nhim411/IoT-module-for-BCS2/DOC/HARDWARE/SCHEMATIC/BUTTONLED_SCHE.pdf

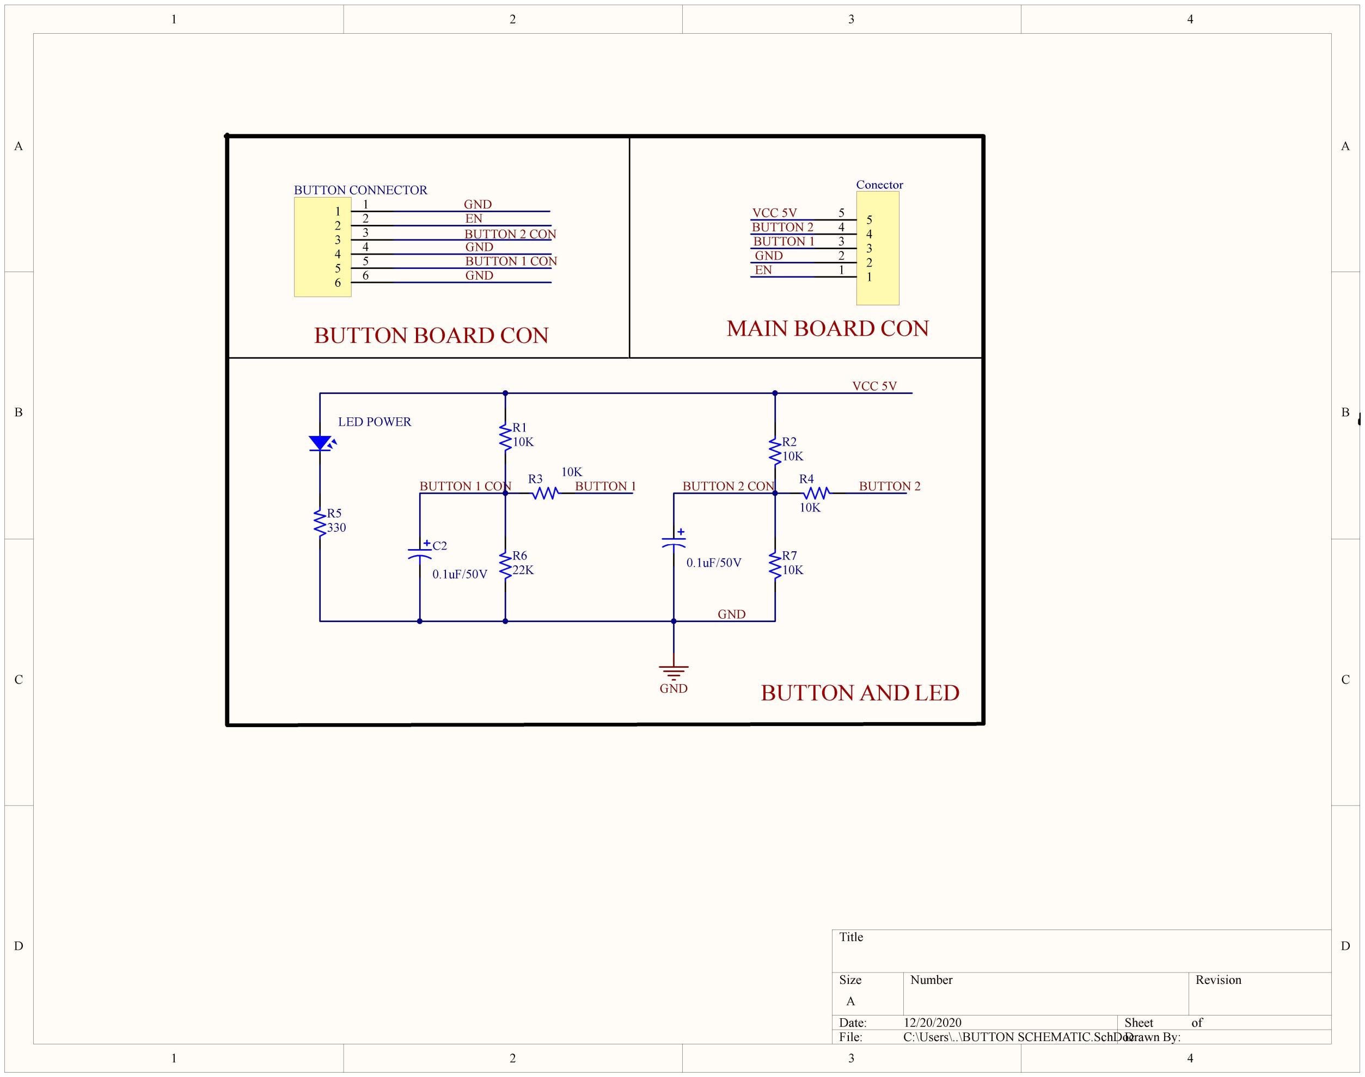
[picture p5: page 1]

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
Title

Size | Number | | Revision
A
Date: | 12/20/2020 | Sheet | of
File: | C:\Users\..\BUTTON SCHEMATIC.SchDocDrawn By:

R1
10K

R3 10K

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
Conector

GND

LED POWER

R5
330

0.1uF/50V

C2
0.1uF/50V

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
BUTTON CONNECTOR

GND

GND

EN

EN

BUTTON 1

BUTTON 1 CON | BUTTON 1

BUTTON 1 CON

BUTTON 2 CON

BUTTON 2 CON

GND

GND

VCC 5V

GND

VCC 5V
BUTTON 2

BUTTON 2

BUTTON BOARD CON | MAIN BOARD CON

# BUTTON AND LED
