nhim411/IoT-module-for-BCS2/DOC/HARDWARE/SCHEMATIC/LAN8720_SCHE.pdf

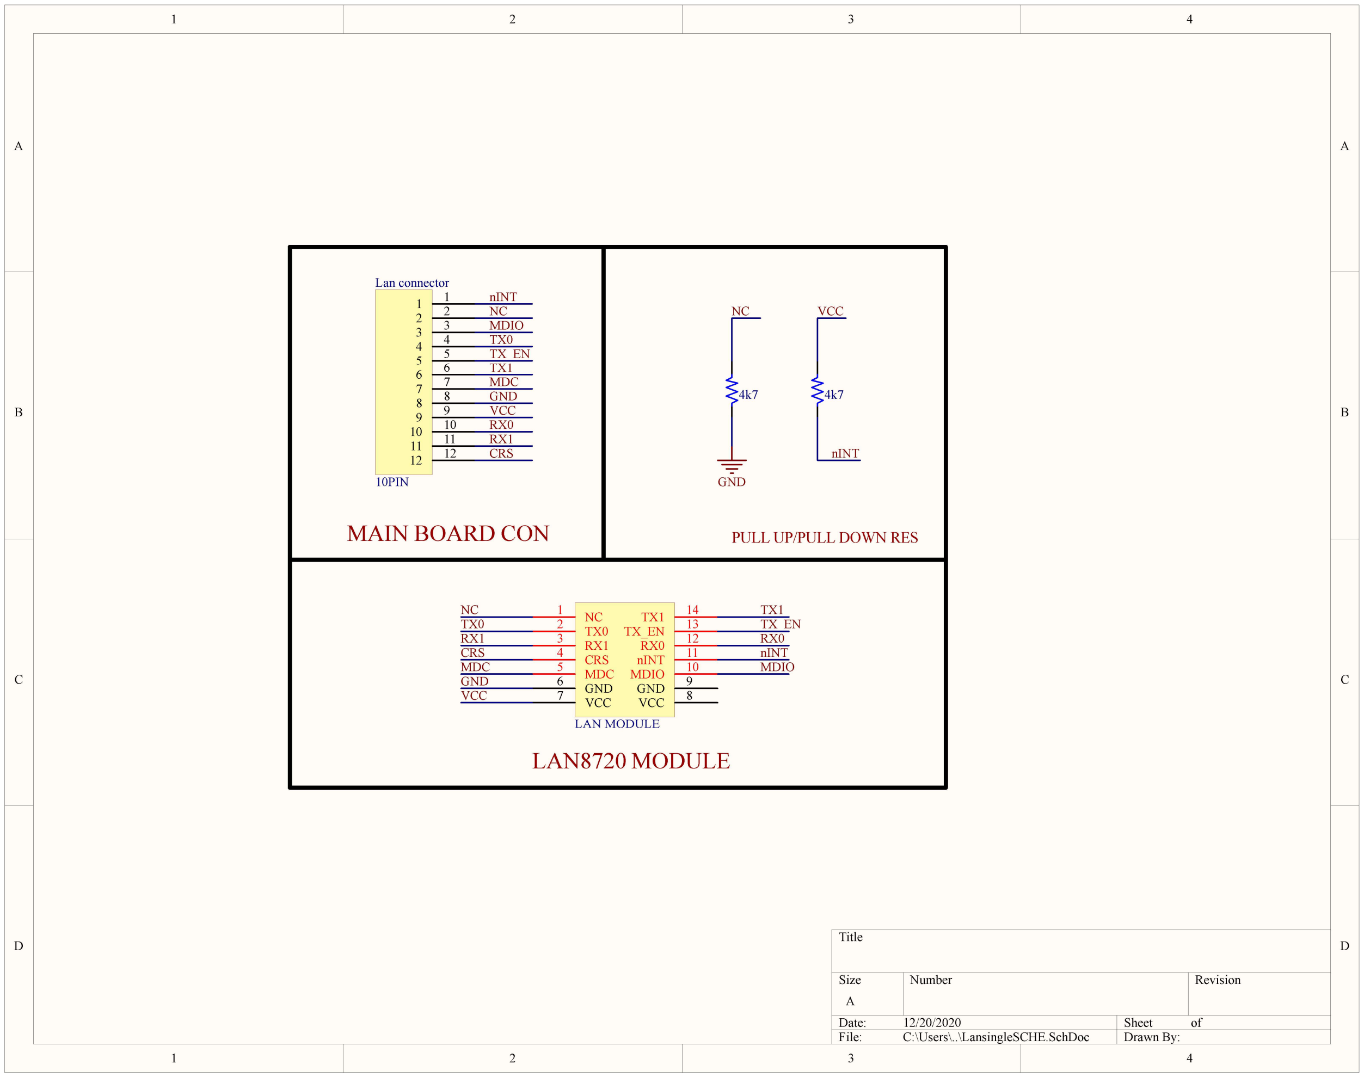
[picture p6: page 1]

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
Title

Size | Number | | Revision
A
Date: | 12/20/2020 | Sheet | of
File: | C:\Users\..\LansingleSCHE.SchDoc | Drawn By:
VCC | 8
GND | 9 MDIO | 10 nINT | 11 RX0 | 12 TX_EN | 13 TX1 | 14 NC 1
TX0 2
RX1 3
CRS 4
MDC 5
GND 6
VCC 7

LAN MODULE

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
10 10
11 11
12 12

Lan connector

10PIN

CRS

RX1

RX0

VCC

GND

MDC

TX1

TX_EN

TX0

MDIO

NC

nINT

4k7 | 4k7

CRS

RX1 | RX0 TX1
| nINT

NC

MDIO
GND
VCC

MDC

TX0 | TX_EN

GND

nINT

NC | VCC
MAIN BOARD CON | PULL UP/PULL DOWN RES

# LAN8720 MODULE
