nhim411/IoT-module-for-BCS2/DOC/HARDWARE/SCHEMATIC/MAIN_CHEMATIC.pdf

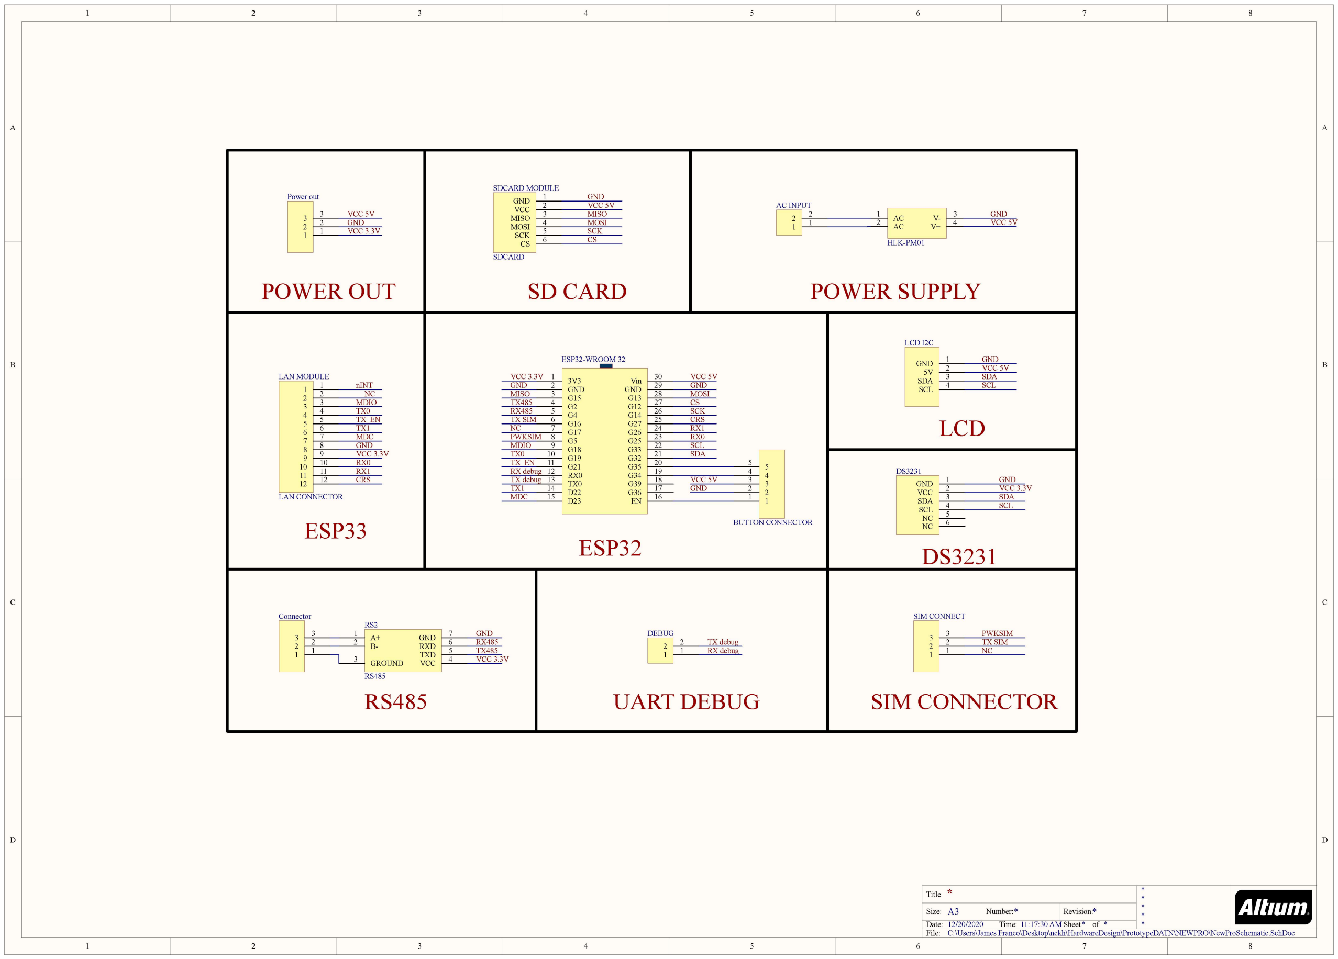
[picture p7: page 1]

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
* | *

*

* | *
12/20/2020 | 11:17:30 AM
C:\Users\James Franco\Desktop\nckh\HardwareDesign\PrototypeDATN\NEWPRO\NewProSchematic.SchDoc

Title

Size: | Number:
Date:
File:

Revision:
Time: | Sheet | of

A3

3V3 1
GND 2
G15 3
G2 4
G4 5
G16 6
G17 7
G5 8
G18 9
G19 10
G21 11
RX0 12
TX0 13
D22 14
D23 15 | EN | 16 G36 | 17 G39 | 18 G34 | 19 G35 | 20 G32 | 21 G33 | 22 G25 | 23 G26 | 24 G27 | 25 G14 | 26 G12 | 27 G13 | 28 GND | 29 Vin | 30

ESP32-WROOM 32

AC 1
AC 2
V- | 3
V+ | 4

HLK-PM01

1

1

2

2

AC INPUT
GND
VCC 5V

VCC 5V
GND | GND 1

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
10 10
11 11
12 12

LAN MODULE

LAN CONNECTOR

nINT
NC
MDIO
TX0
TX_EN
TX1
MDC
GND
VCC 3.3V

RX1

RX0

CRS

VCC 3.3V

NC

MDIO
TX0
TX_EN

TX1
MDC

RX0

RX1

CRS

GND | 1
5V | 2
SDA | 3
SCL | 4

LCD I2C

SCL

SDA

VCC 5V

GND

SCL
SDA

A+ 1
B- 2
GROUND 3 | VCC | 4
| TXD | 5
RXD | 6
GND | 7

RS2

RS485

GND

VCC 3.3V

RX485
TX485 1

1

2

2

3

3

Connector

1

1

2

2

3

3

Power out

VCC 5V

VCC 3.3V

GND

1

1

2

2

DEBUG

RX debug

RX debug
TX debug

TX debug
1

1

2

2

3

3

SIM CONNECT

PWKSIM
TX SIM

TX SIM

NC

PWKSIM

GND | 1
VCC | 2
MISO | 3
MOSI | 4
SCK | 5
CS | 6

SDCARD MODULE

SDCARD

VCC 5V

GND

MISO

MISO

MOSI

MOSI

SCK

SCK
CS

CS

GND | 1
VCC | 2
SDA | 3
SCL | 4
NC | 5
NC | 6

DS3231
GND

SDA
SCL

VCC 3.3V

TX485
RX485

VCC 5V
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
BUTTON CONNECTOR

# ESP32

SD CARD | POWER SUPPLY

DS3231

# LCD

RS485 | UART DEBUG | SIM CONNECTOR

# ESP33

# POWER OUT
