nhim411/IoT-module-for-BCS2/DOC/HARDWARE/MACH_IN/BUTTON/BUTLAYOUT.JPG

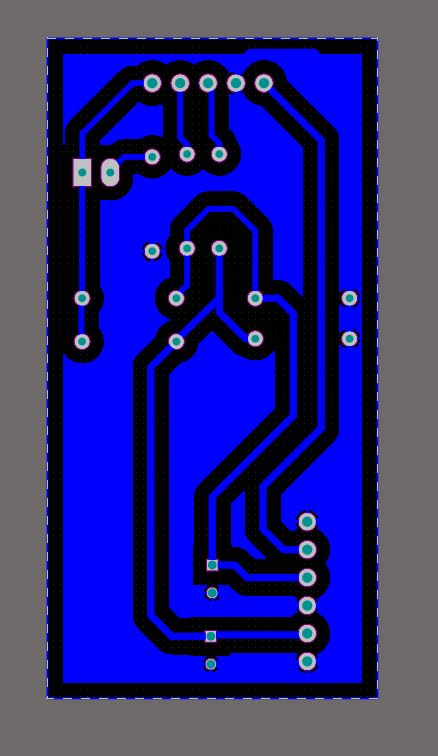
DOC/HARDWARE/MACH_IN/BUTTON/BUTLAYOUT.JPG
