nhim411/IoT-module-for-BCS2/DOC/HARDWARE/MACH_IN/LAN/lANLAYOUT2.JPG

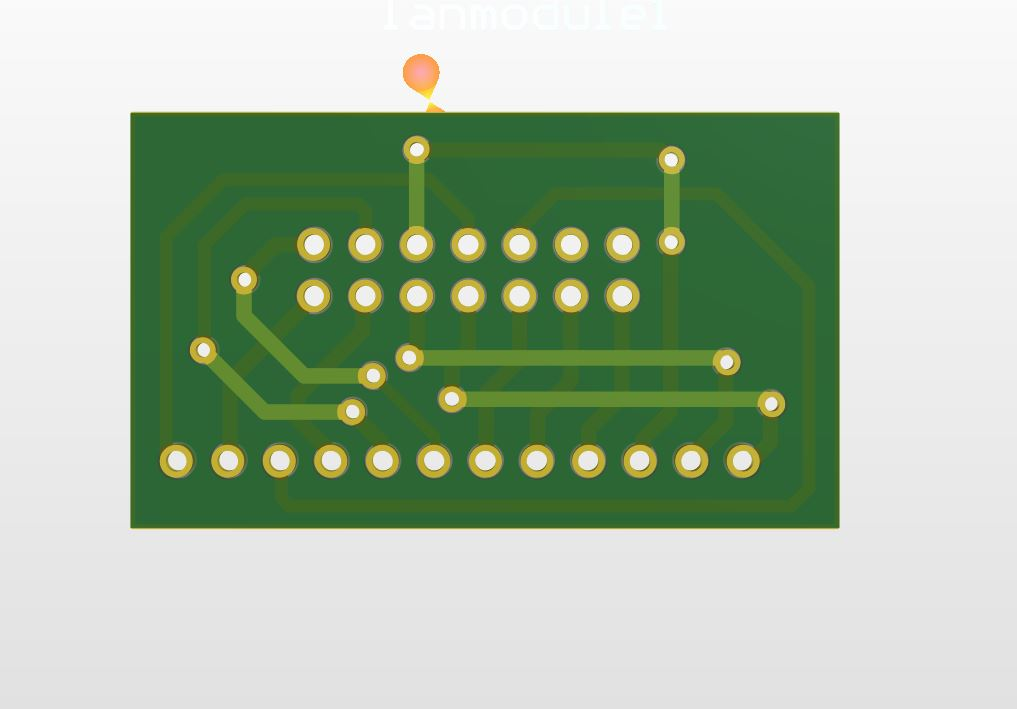
DOC/HARDWARE/MACH_IN/LAN/lANLAYOUT2.JPG
