nhim411/IoT-module-for-BCS2/DOC/HARDWARE/MACH_IN/LAN/lANLAYOUT.JPG

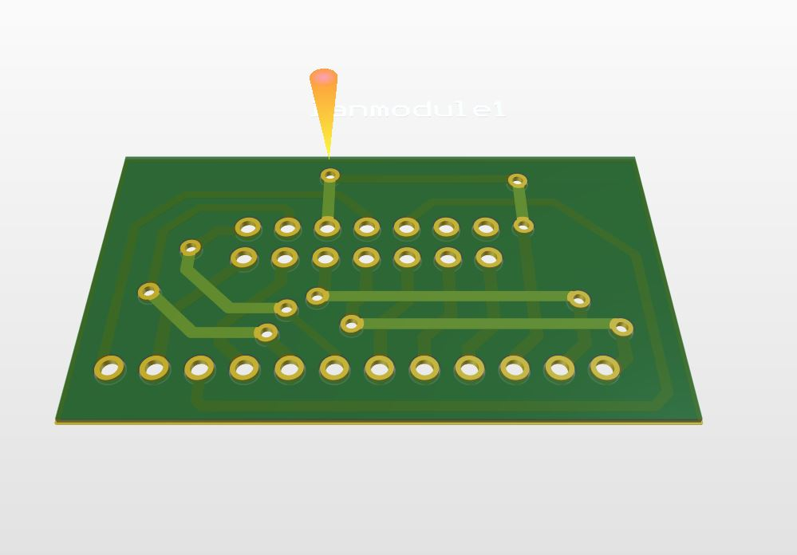
DOC/HARDWARE/MACH_IN/LAN/lANLAYOUT.JPG
