nhim411/IoT-module-for-BCS2/DOC/HARDWARE/MACH_IN/MAIN/Capture.JPG

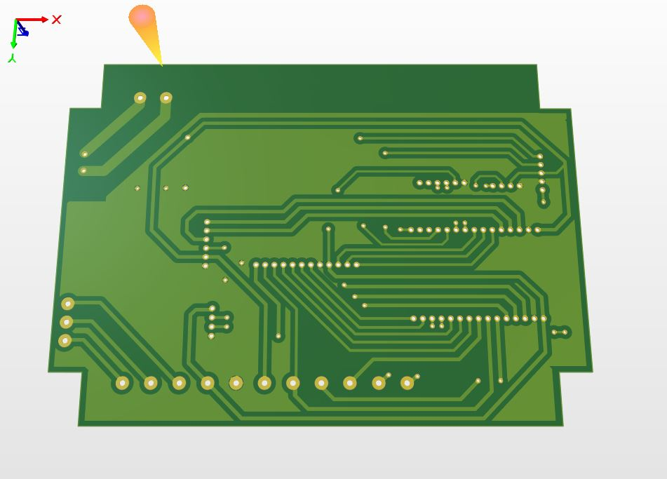
DOC/HARDWARE/MACH_IN/MAIN/Capture.JPG
