nhim411/IoT-module-for-BCS2/HINH-ANH/qua trinh phat trien/83ab2cc8ac365d680427.jpg

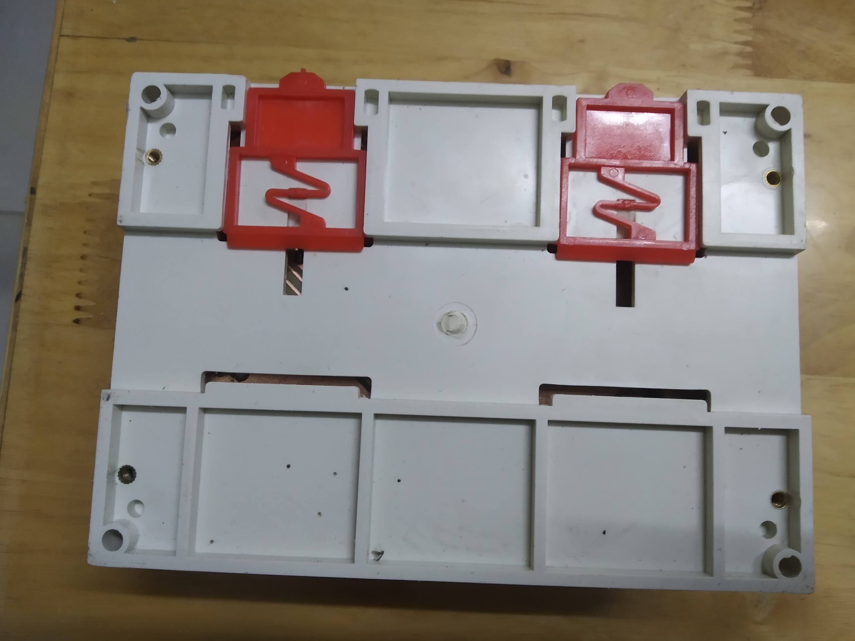
HINH-ANH/qua trinh phat trien/83ab2cc8ac365d680427.jpg
