nhim411/IoT-module-for-BCS2/HINH-ANH/qua trinh phat trien/2020-12-18 125916.jpg

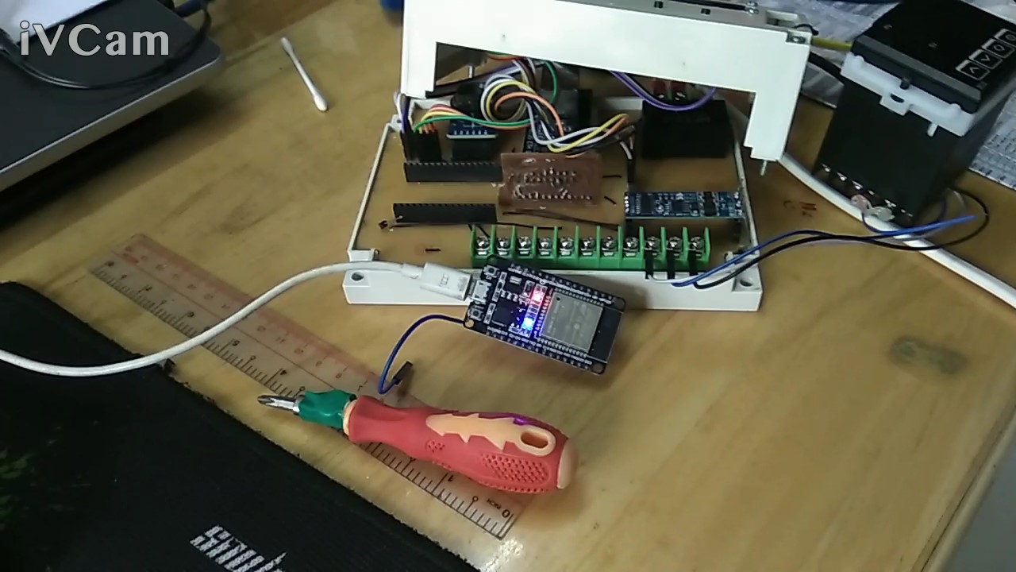
HINH-ANH/qua trinh phat trien/2020-12-18 125916.jpg
