nhim411/IoT-module-for-BCS2/HINH-ANH/qua trinh phat trien/7915d50a55f4a4aafde5.jpg

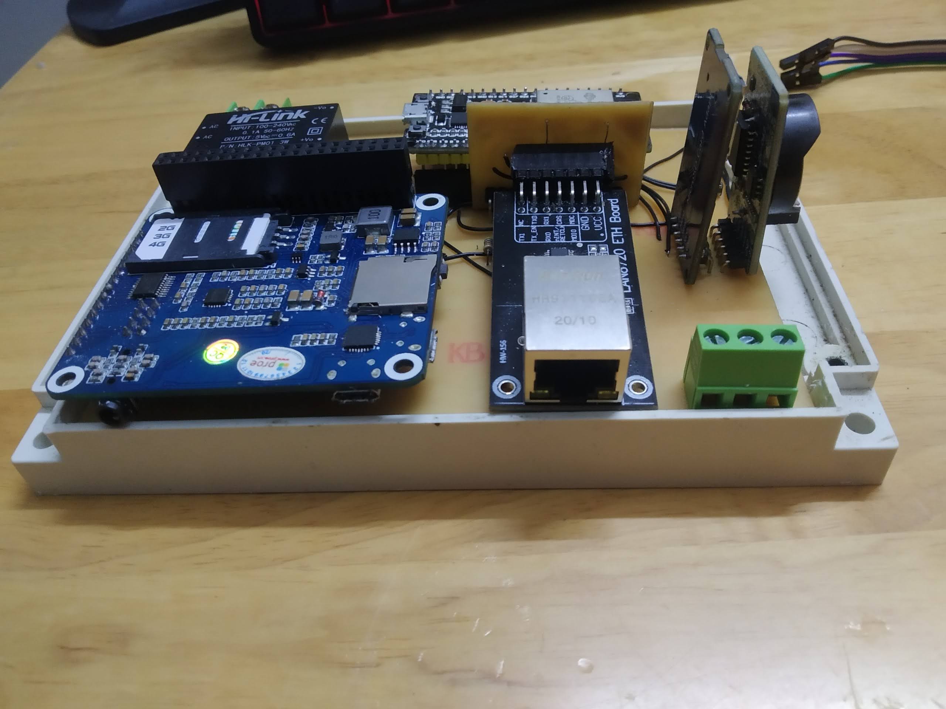
HINH-ANH/qua trinh phat trien/7915d50a55f4a4aafde5.jpg
