nhim411/IoT-module-for-BCS2/HINH-ANH/qua trinh phat trien/35601273928d63d33a9c.jpg

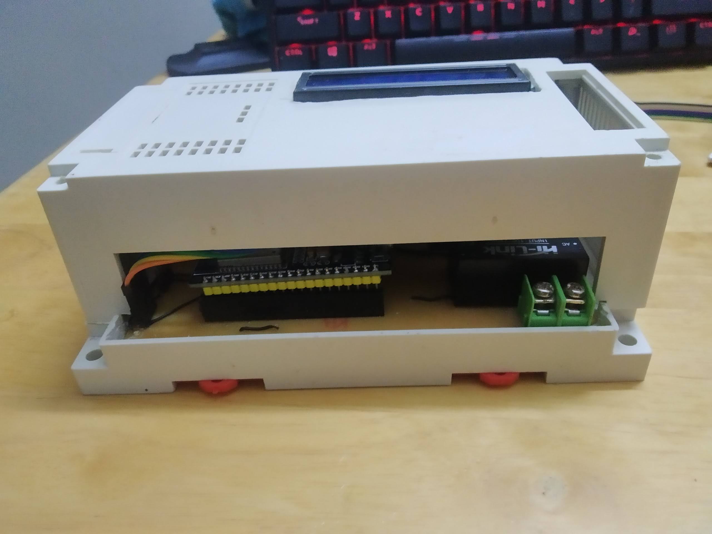
HINH-ANH/qua trinh phat trien/35601273928d63d33a9c.jpg
