nhim411/IoT-module-for-BCS2/HINH-ANH/qua trinh phat trien/a3eb0486847875262c69.jpg

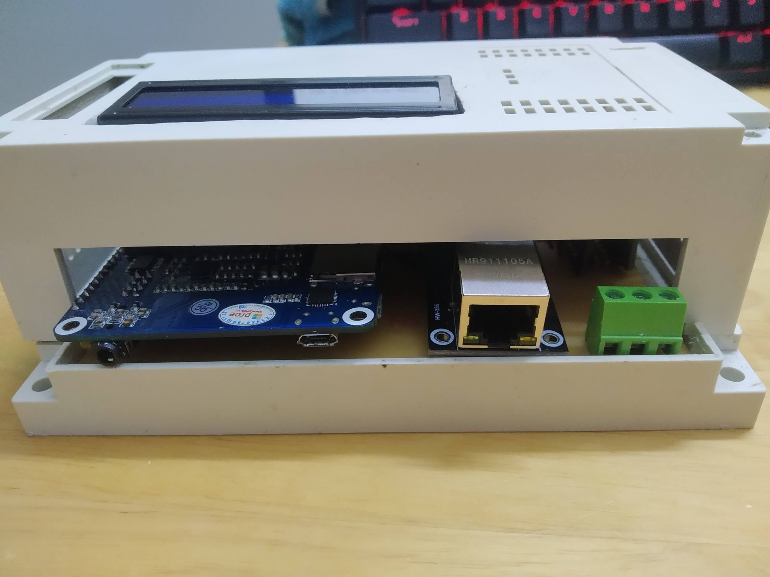
HINH-ANH/qua trinh phat trien/a3eb0486847875262c69.jpg
