nhim411/IoT-module-for-BCS2/HINH-ANH/qua trinh phat trien/dffd0df18d0f7c51251e.jpg

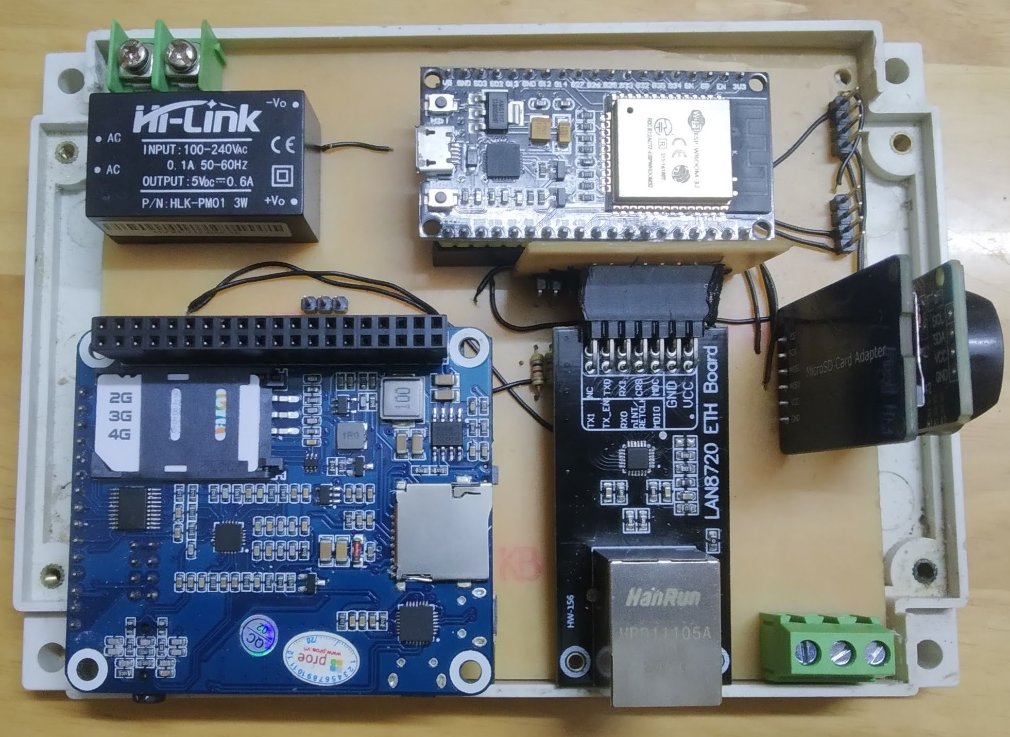
HINH-ANH/qua trinh phat trien/dffd0df18d0f7c51251e.jpg
