nhim411/IoT-module-for-BCS2/HINH-ANH/qua trinh phat trien/IMG_20201003_192744.jpg

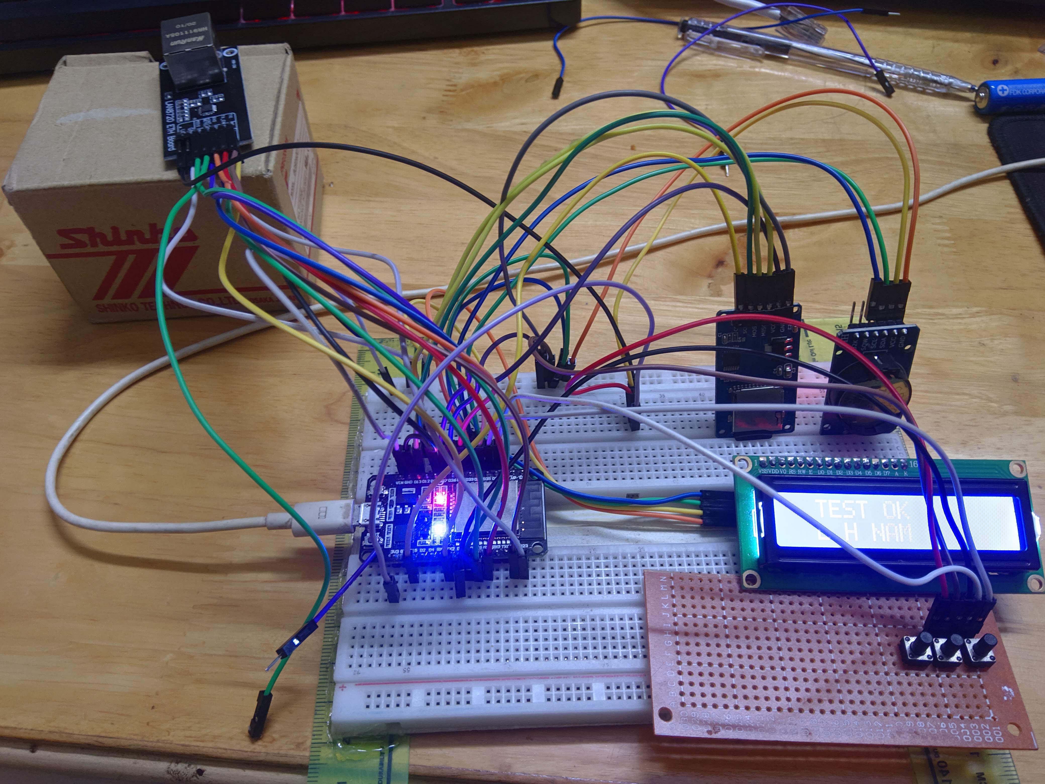
HINH-ANH/qua trinh phat trien/IMG_20201003_192744.jpg
