nhim411/IoT-module-for-BCS2/HINH-ANH/qua trinh phat trien/IMG_20201126_083545.jpg

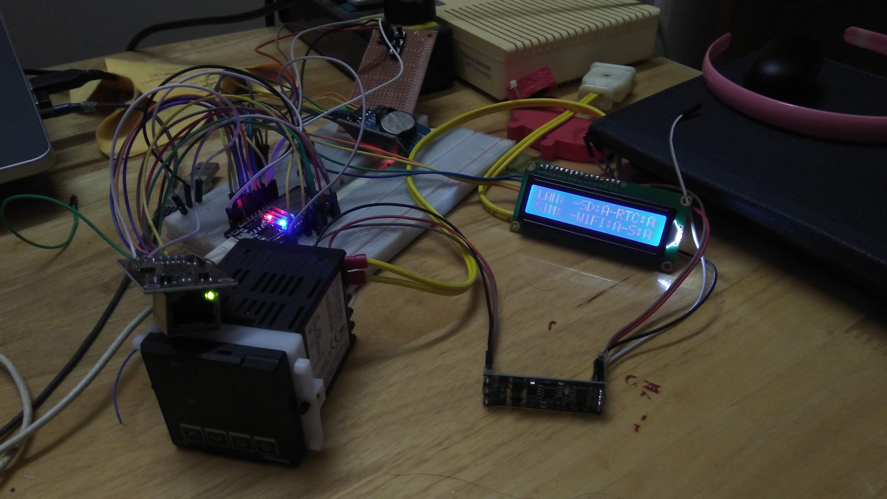
HINH-ANH/qua trinh phat trien/IMG_20201126_083545.jpg
