nhim411/IoT-module-for-BCS2/HINH-ANH/qua trinh phat trien/IMG_20201221_082623.jpg

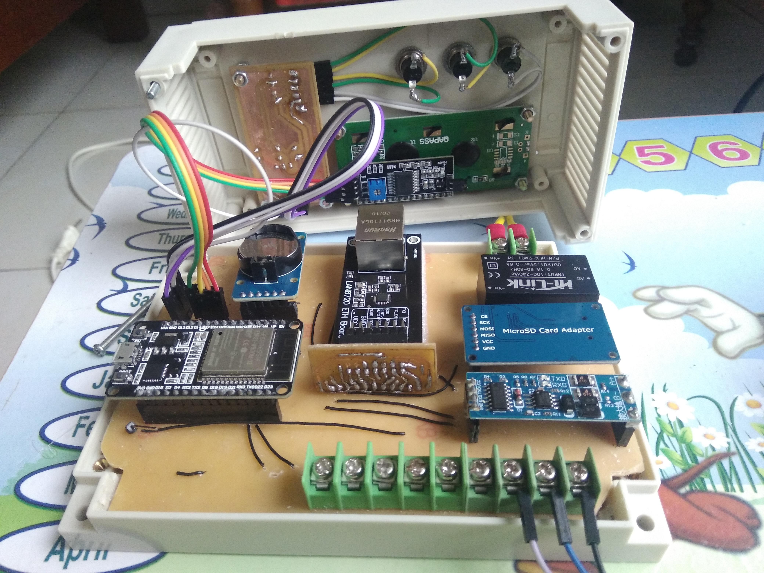
HINH-ANH/qua trinh phat trien/IMG_20201221_082623.jpg
