nhim411/IoT-module-for-BCS2/HINH-ANH/san pham hoan thien/IMG_20201220_102822 (1).jpg

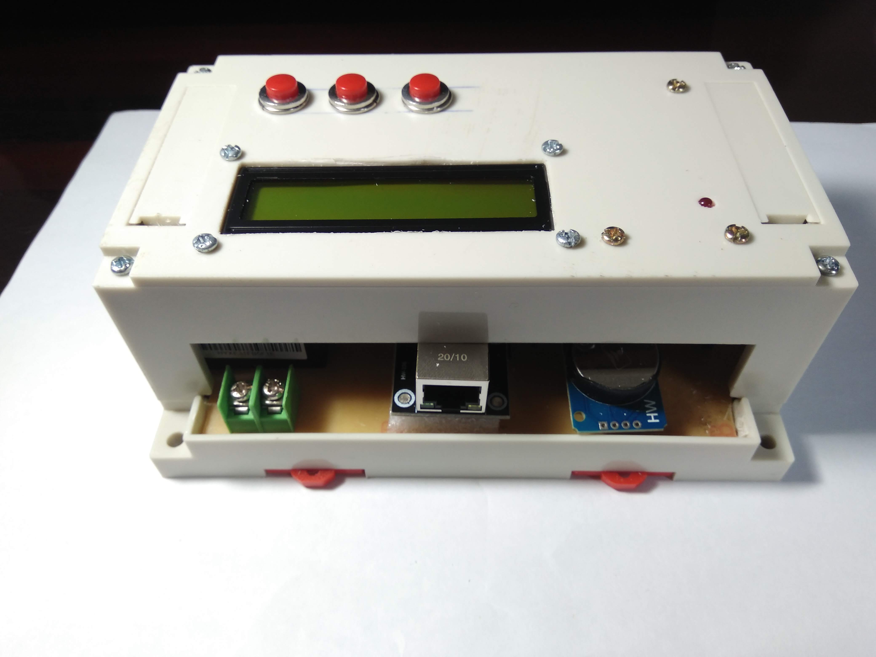
HINH-ANH/san pham hoan thien/IMG_20201220_102822 (1).jpg
