nhim411/IoT-module-for-BCS2/HINH-ANH/san pham hoan thien/IMG_20201222_135530.jpg

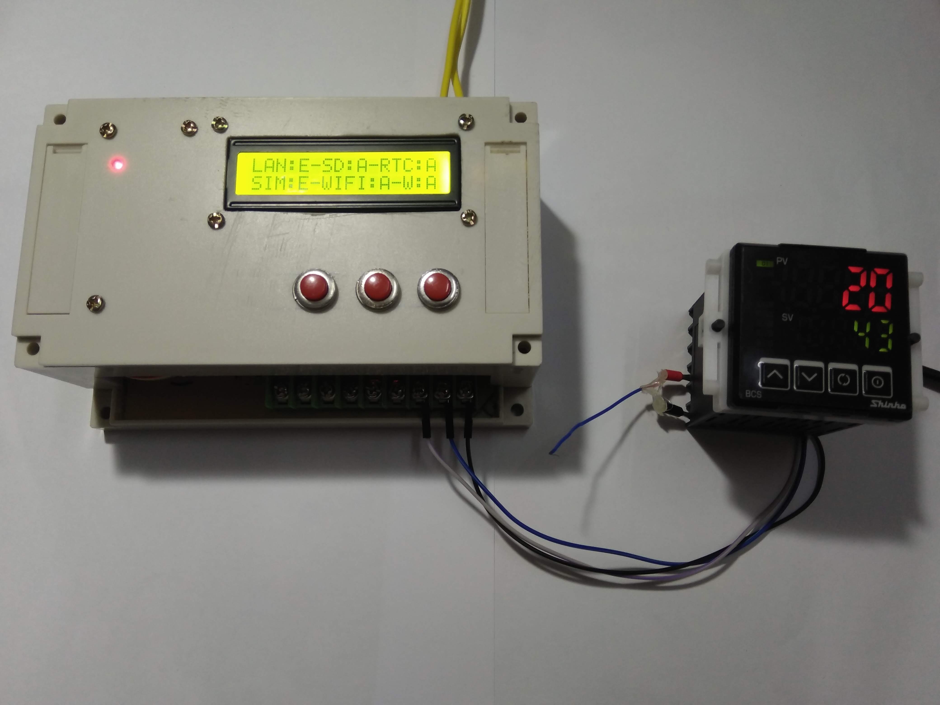
HINH-ANH/san pham hoan thien/IMG_20201222_135530.jpg
