nhim411/IoT-module-for-BCS2/HINH-ANH/web server/config bcs2.png

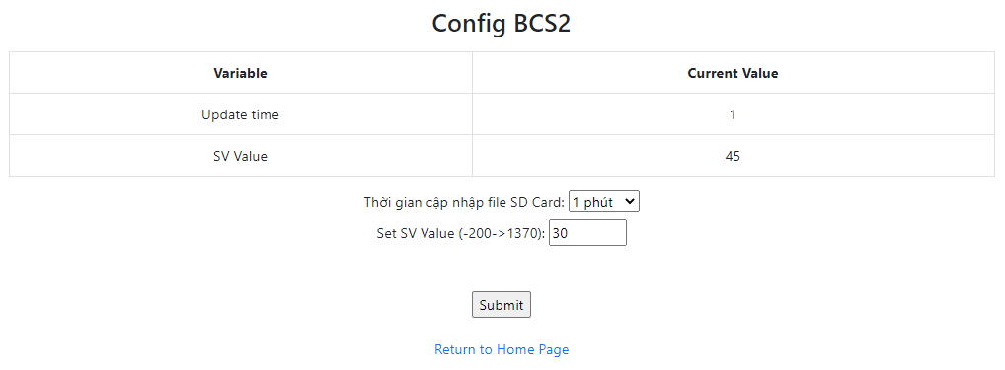
HINH-ANH/web server/config bcs2.png
