nhim411/IoT-module-for-BCS2/HINH-ANH/web server/config ftp.png

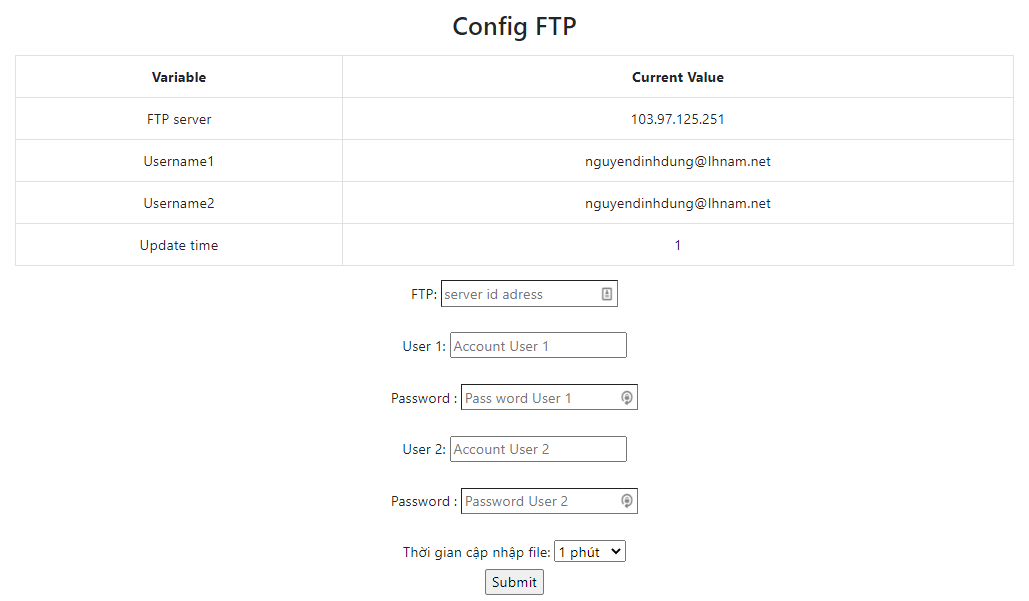
HINH-ANH/web server/config ftp.png
