nhim411/IoT-module-for-BCS2/HINH-ANH/web server/download.png

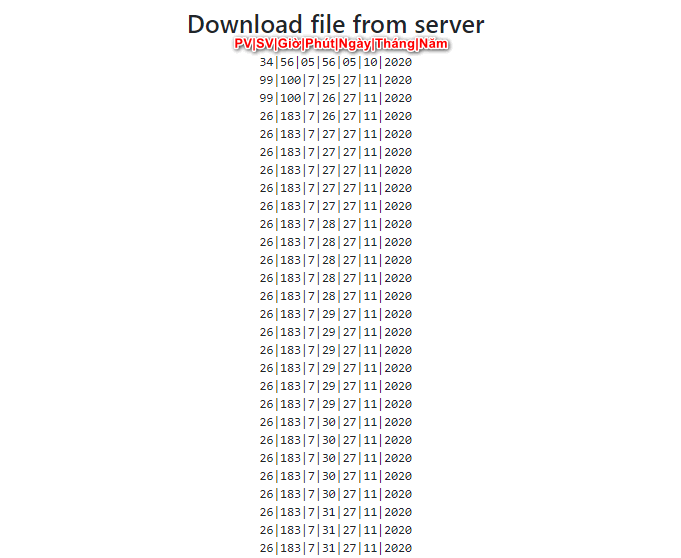
HINH-ANH/web server/download.png
