nhim411/IoT-module-for-BCS2/HINH-ANH/web server/ota update.png

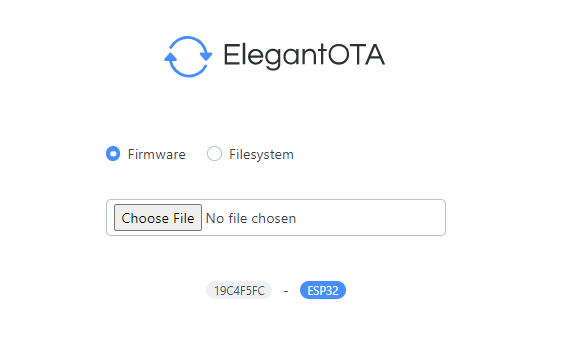
HINH-ANH/web server/ota update.png
