nhim411/IoT-module-for-BCS2/HINH-ANH/web server/settings.png

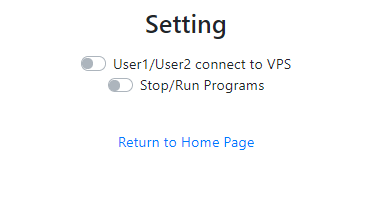
HINH-ANH/web server/settings.png
