nhim411/IoT-module-for-BCS2/HINH-ANH/web server/show.png

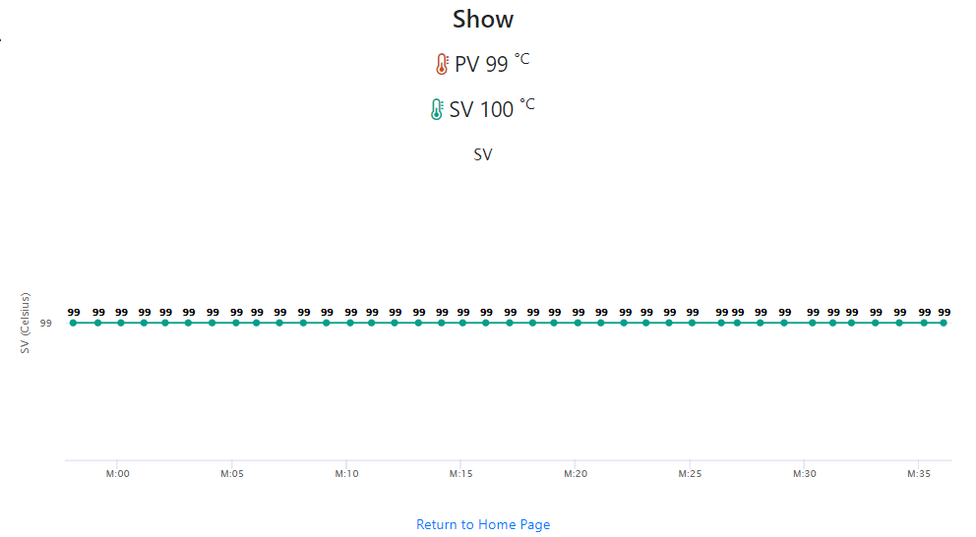
HINH-ANH/web server/show.png
