nhim411/IoT-module-for-BCS2/DOC/HARDWARE/PCB/BUTTONLED_PCB.pdf

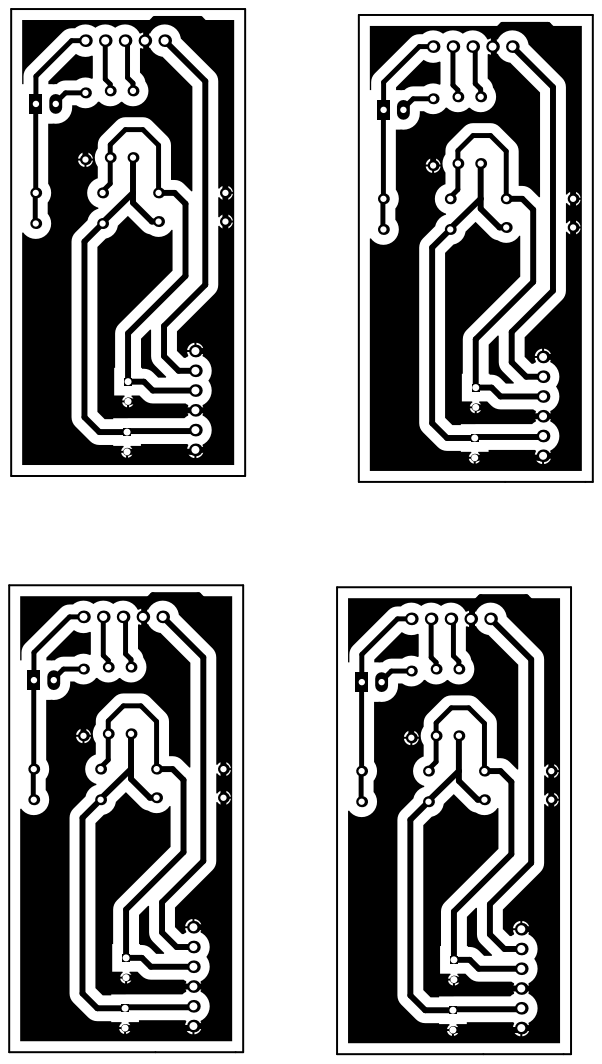
[picture p99: page 1]
