nhim411/IoT-module-for-BCS2/DOC/HARDWARE/PCB/LAN8720_PCB.pdf

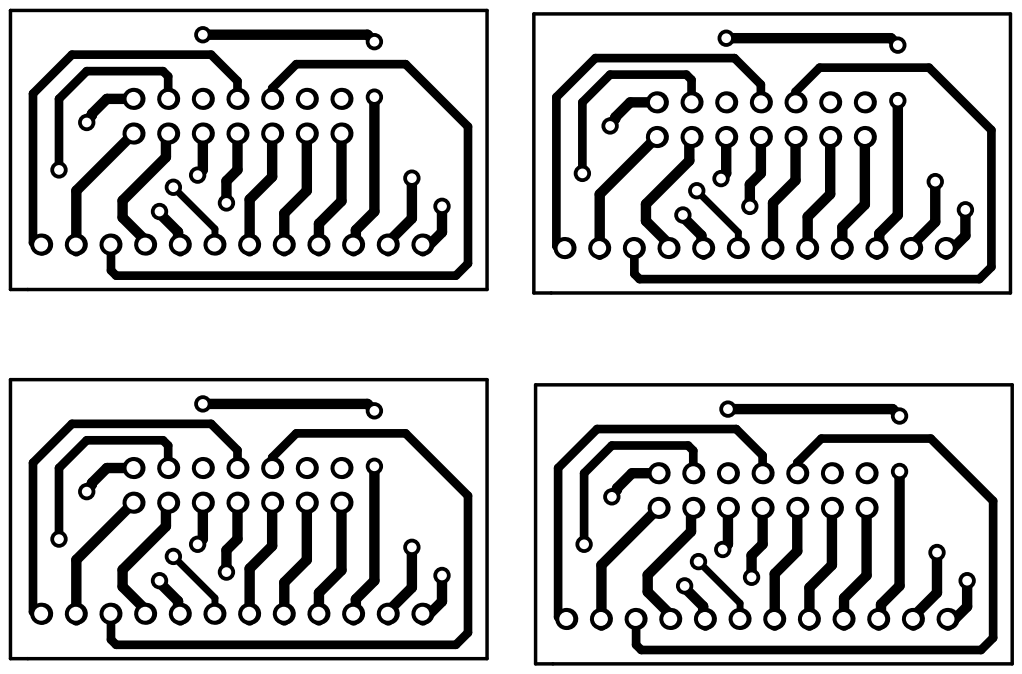
[picture p100: page 1]
