nhim411/IoT-module-for-BCS2/DOC/HARDWARE/PCB/MAIN_PCB.pdf

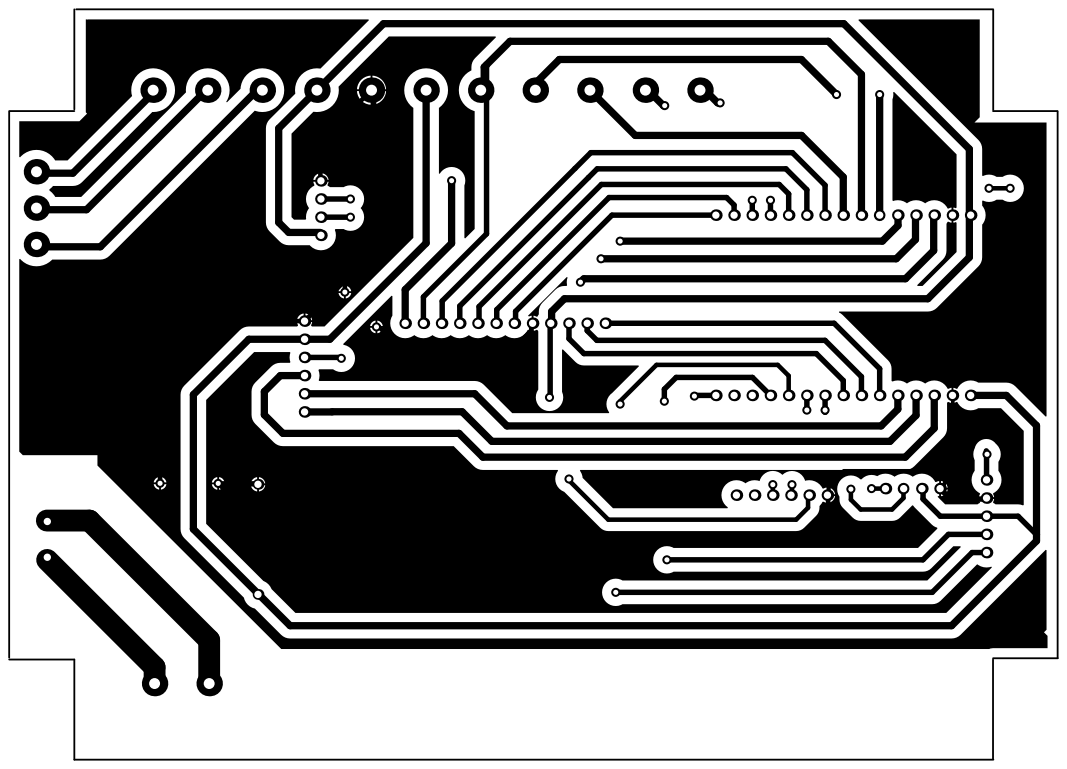
[picture p101: page 1]
