nhim411/IoT-module-for-BCS2/DOC/SOFTWARE/CODE/functions.h

String readFile(fs::FS &fs, const char * path) {
  Serial.printf("Reading file: %s\r\n", path);
  File file = fs.open(path, "r");
  if (!file || file.isDirectory()) {
    Serial.println("- empty file or failed to open file");
    return String();
  }
  Serial.println("- read from file:");
  String fileContent;
  while (file.available()) {
    fileContent += String((char)file.read());
  }
  Serial.println(fileContent);
  file.close();
  return fileContent;
}

void writeFile(fs::FS &fs, const char * path, const char * message) {
  Serial.printf("Writing file: %s\r\n", path);
  File file = fs.open(path, "w");
  if (!file) {
    Serial.println("- failed to open file for writing");
    return;
  }
  if (file.print(message)) {
    Serial.println("- file written");
  } else {
    Serial.println("- write failed");
  }
  file.close();
}

// Replaces placeholder with stored values
String processor(const String &var)
{
  //Serial.println(var);
  if (var == "baud")
  {
    return readFile(SPIFFS, "/baud.txt");
  }
  if (var == "data_bit")
  {
    return readFile(SPIFFS, "/data_bit.txt");
  }
  if (var == "stop_bit")
  {
    return readFile(SPIFFS, "/stop_bit.txt");
  }
  if (var == "parity")
  {
    return readFile(SPIFFS, "/parity.txt");
  }
  if (var == "instrument")
  {
    return readFile(SPIFFS, "/instrument.txt");
  }
  if (var == "ftp_server")
  {
    return readFile(SPIFFS, "/ftp_server.txt");
  }
  if (var == "user1")
  {
    return readFile(SPIFFS, "/user1.txt");
  }
  if (var == "user2")
  {
    return readFile(SPIFFS, "/user2.txt");
  }
  if (var == "time_update_ftp")
  {
    return readFile(SPIFFS, "/time_update_ftp.txt");
  }
  if (var == "time_update_sd")
  {
    return readFile(SPIFFS, "/time_update_sd.txt");
  }
  if (var == "sv")
  {
    return sv;
  }
  if (var == "pv")
  {
    return pv;
  }
  if (var == "DOWNLOAD")
  {
    return download_ftp;
  }
  if (var == "set_sv")
  {
    return set_sv;
  }
  if (var == "wf_ssid")
  {
    return wf_ssid;
  }  if (var == "wf_password")
  {
    return wf_password;
  }
  return String();
}

String decToHex(int decValue) {
  String hexString = String(decValue, HEX);
  while (hexString.length() < 4) hexString = "0" + hexString;
  return hexString;
}
byte StrtoByte (String str_value) {
  char char_buff[3];
  str_value.toCharArray(char_buff, 3);
  byte byte_value = strtoul(char_buff, NULL, 16);
  return byte_value;
}
String ModRTU_CRC(String raw_msg_data) {
  //Calc raw_msg_data length
  byte raw_msg_data_byte[raw_msg_data.length() / 2];
  //Convert the raw_msg_data to a byte array raw_msg_data
  for (int i = 0; i < raw_msg_data.length() / 2; i++) {
    raw_msg_data_byte[i] = StrtoByte(raw_msg_data.substring(2 * i, 2 * i + 2));
  }

  //Calc the raw_msg_data_byte CRC code
  uint16_t crc = 0xFFFF;
  String crc_string = "";
  for (int pos = 0; pos < raw_msg_data.length() / 2; pos++) {
    crc ^= (uint16_t)raw_msg_data_byte[pos];          // XOR byte into least sig. byte of crc
    for (int i = 8; i != 0; i--) {    // Loop over each bit
      if ((crc & 0x0001) != 0) {      // If the LSB is set
        crc >>= 1;                    // Shift right and XOR 0xA001
        crc ^= 0xA001;
      }
      else                            // Else LSB is not set
        crc >>= 1;                    // Just shift right
    }
  }
  // Note, this number has low and high bytes swapped, so use it accordingly (or swap bytes)

  //Become crc byte to a capital letter String
  crc_string = String(crc, HEX);
  crc_string.toUpperCase();

  //The crc should be like XXYY. Add zeros if need it
  if (crc_string.length() == 1) {
    crc_string = "000" + crc_string;
  } else if (crc_string.length() == 2) {
    crc_string = "00" + crc_string;
  } else if (crc_string.length() == 3) {
    crc_string = "0" + crc_string;
  } else {
    //OK
  }

  //Invert the byte positions
  crc_string = crc_string.substring(2, 4) + crc_string.substring(0, 2);
  return crc_string;
}
boolean onRTS = false;
boolean onSD = false;
boolean onWIFI = false;
boolean onETH = false;
boolean onServer = false;


//String to byte --> Example: String = "C4" --> byte = {0xC4}
//void WiFiEvent(WiFiEvent_t event) {
//  switch (event) {
//    case SYSTEM_EVENT_ETH_START:
//      Serial.println("ETH Started");
//      //set eth hostname here
//      ETH.setHostname("esp32-ethernet");
//      break;
//    case SYSTEM_EVENT_ETH_CONNECTED:
//      Serial.println("ETH Connected");
//      break;
//    case SYSTEM_EVENT_ETH_GOT_IP:
//      Serial.print("ETH MAC: ");
//      Serial.print(ETH.macAddress());
//      Serial.print(", IPv4: ");
//      Serial.print(ETH.localIP());
//      if (ETH.fullDuplex()) {
//        Serial.print(", FULL_DUPLEX");
//      }
//      Serial.print(", ");
//      Serial.print(ETH.linkSpeed());
//      Serial.println("Mbps");
//      eth_connected = true;
//      break;
//    case SYSTEM_EVENT_ETH_DISCONNECTED:
//      Serial.println("ETH Disconnected");
//      eth_connected = false;
//      break;
//    case SYSTEM_EVENT_ETH_STOP:
//      Serial.println("ETH Stopped");
//      eth_connected = false;
//      break;
//    default:
//      break;
//  }
//}
//
//void testClient(const char * host, uint16_t port) {
//  Serial.print("\nconnecting to ");
//  Serial.println(host);
//
//  WiFiClient client;
//  if (!client.connect(host, port)) {
//    Serial.println("connection failed");
//    return;
//  }
//  client.printf("GET / HTTP/1.1\r\nHost: %s\r\n\r\n", host);
//  while (client.connected() && !client.available());
//  while (client.available()) {
//    Serial.write(client.read());
//  }
//
//  Serial.println("closing connection\n");
//  client.stop();
//}
