nhim411/IoT-module-for-BCS2/DOC/SOFTWARE/CODE/libraries.h

// Import required libraries
#include <Arduino.h>
#include <WiFi.h>
#include <WiFiClient.h>
#include <AsyncElegantOTA.h>
#include <ESP32_FTPClient.h>
#include "ESPAsyncWebServer.h"
#include <AsyncTCP.h>
#include <SPIFFS.h>
#include "ESPmDNS.h"
#include <EEPROM.h>
//#include <ETH.h>

#include "LiquidCrystal_PCF8574.h"
#include "Button.h"
#include "Wire.h"
#include "RTClib.h"
#include <SD.h>
#include <SPI.h>
#include "Ethernet.h"
